SRT31/high-speed-camera/poster/High-Speed_Camera_for_Capturing_Polymerization.pdf

# High-Speed Camera System

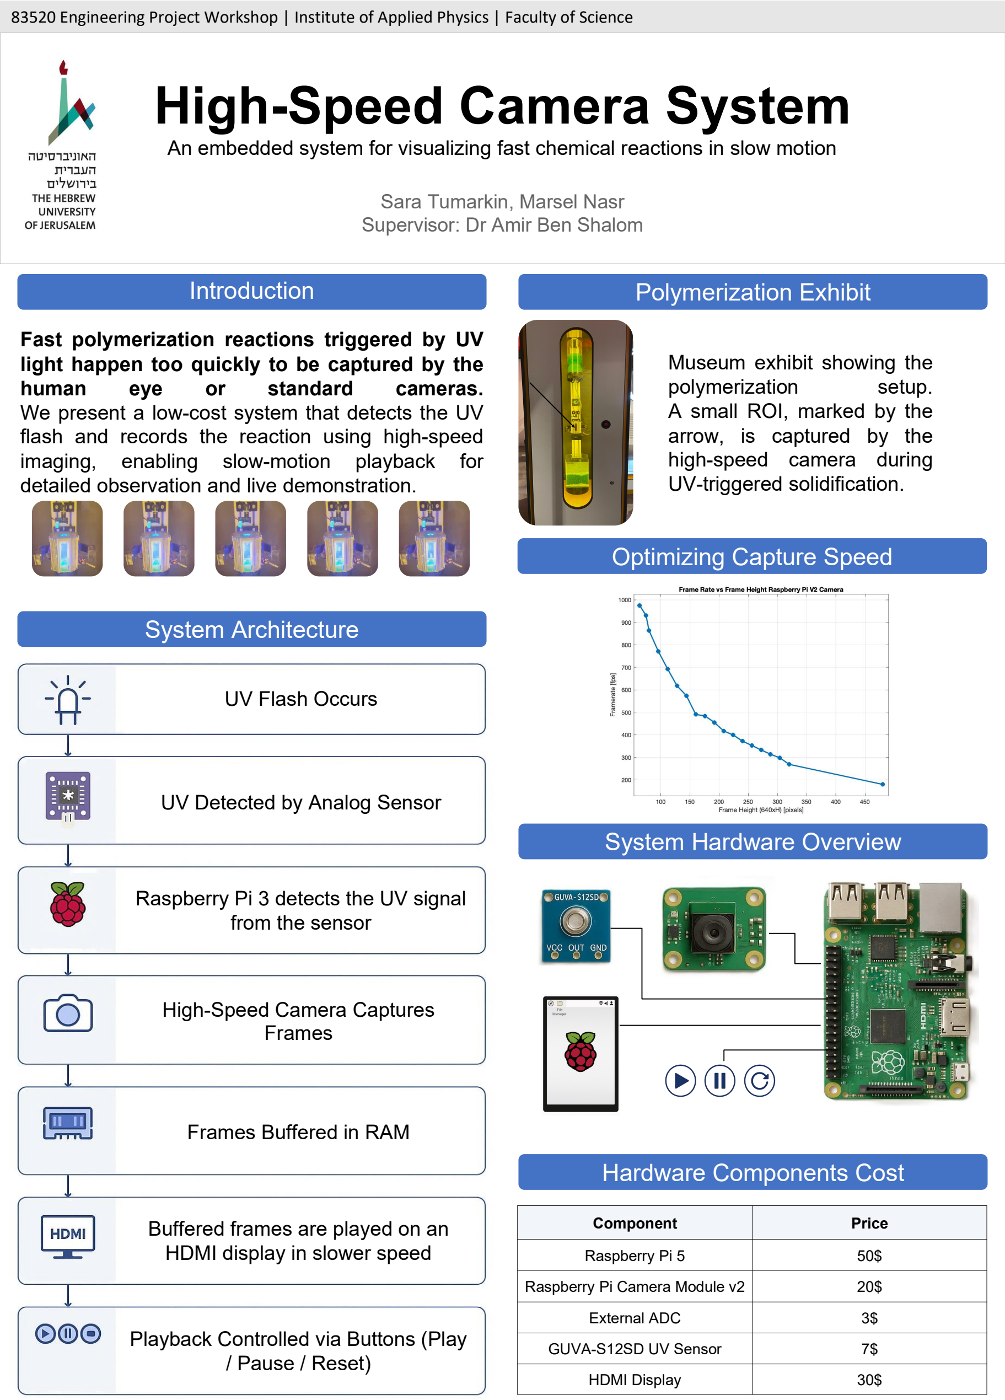
[picture p33: page 1]

83520 Engineering Project Workshop | Institute of Applied Physics | Faculty of Science

An embedded system for visualizing fast chemical reactions in slow motion

Sara Tumarkin, Marsel Nasr Supervisor: Dr Amir Ben Shalom

### Introduction

Fast polymerization reactions triggered by UV light happen too quickly to be captured by the
human | eye | or | standard | cameras.
We present a low-cost system that detects the UV flash and records the reaction using high-speed
imaging, | enabling | slow-motion | playback | for
detailed observation and live demonstration.

### System Architecture

### Polymerization Exhibit

Museum exhibit showing the
polymerization | setup.
A small ROI, marked by the arrow, is captured by the
high-speed camera during
UV-triggered solidification.

UV Flash Occurs

UV Detected by Analog Sensor

Raspberry Pi 3 detects the UV signal from the sensor

High-Speed Camera Captures Frames

Frames Buffered in RAM

Playback Controlled via Buttons (Play / Pause / Reset)

### System Hardware Overview

### Hardware Components Cost

Component | Price
Raspberry Pi 5 | 50$
Raspberry Pi Camera Module v2 | 20$
External ADC | 3$
GUVA-S12SD UV Sensor | 7$
HDMI Display | 30$

Buffered frames are played on an HDMI display in slower speed

### Optimizing Capture Speed
