SRT31/high-speed-camera/PCB_drop_sensor.png

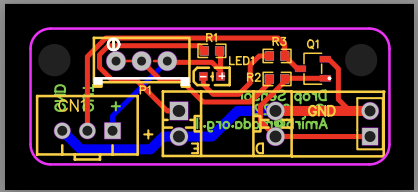
PCB_drop_sensor.png
