SRT31/high-speed-camera/poster/fps_vs_height_table.png

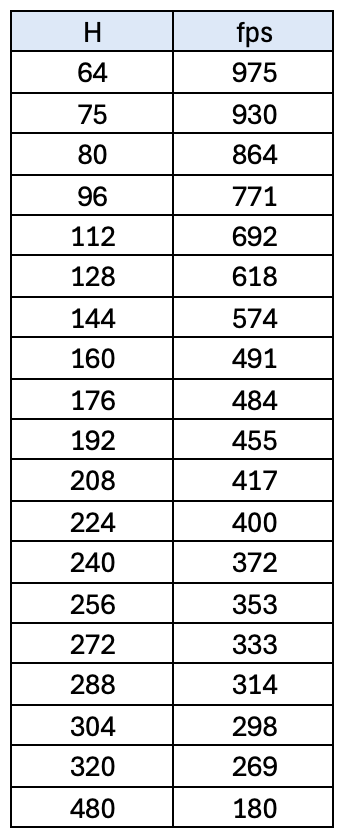
poster/fps_vs_height_table.png
