SRT31/high-speed-camera/Schematic_PHOTOPOLYMER_CURE_LIGHT_V0_0_2025-07-21.png

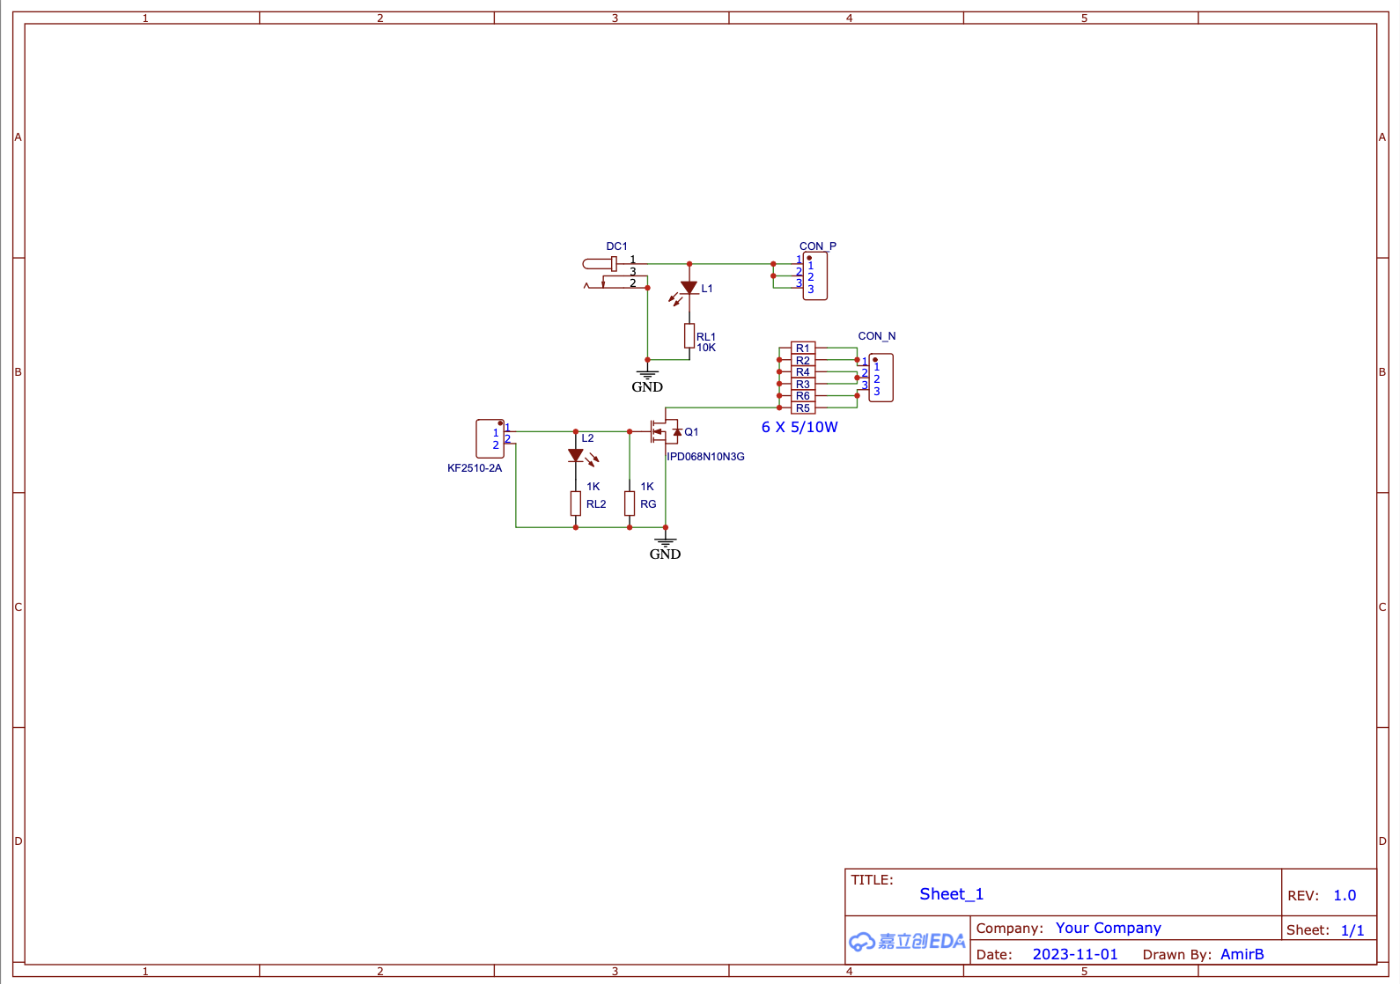
Schematic_PHOTOPOLYMER_CURE_LIGHT_V0_0_2025-07-21.png
