SRT31/high-speed-camera/Screenshot 2025-08-14 at 18.59.24.png

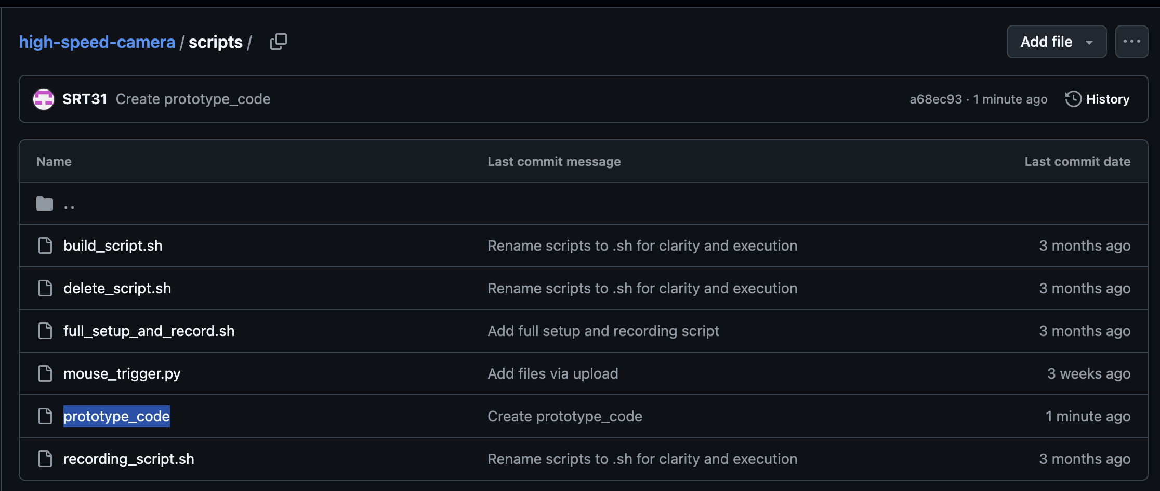
Screenshot 2025-08-14 at 18.59.24.png
