SRT31/high-speed-camera/(commit log)

2025-05-19 Add FPS vs Height table (image and CSV)
    [fps_vs_height.csv]
2025-07-14 Added test video section after dark frame observation
2025-08-14 Create prototype_code
